HissenGneg/adaptive_light/Hardware/UserInterface/UserInterface.kicad_pcb

## KiCad design Hardware/UserInterface/UserInterface.kicad_pcb (2024-05-02)

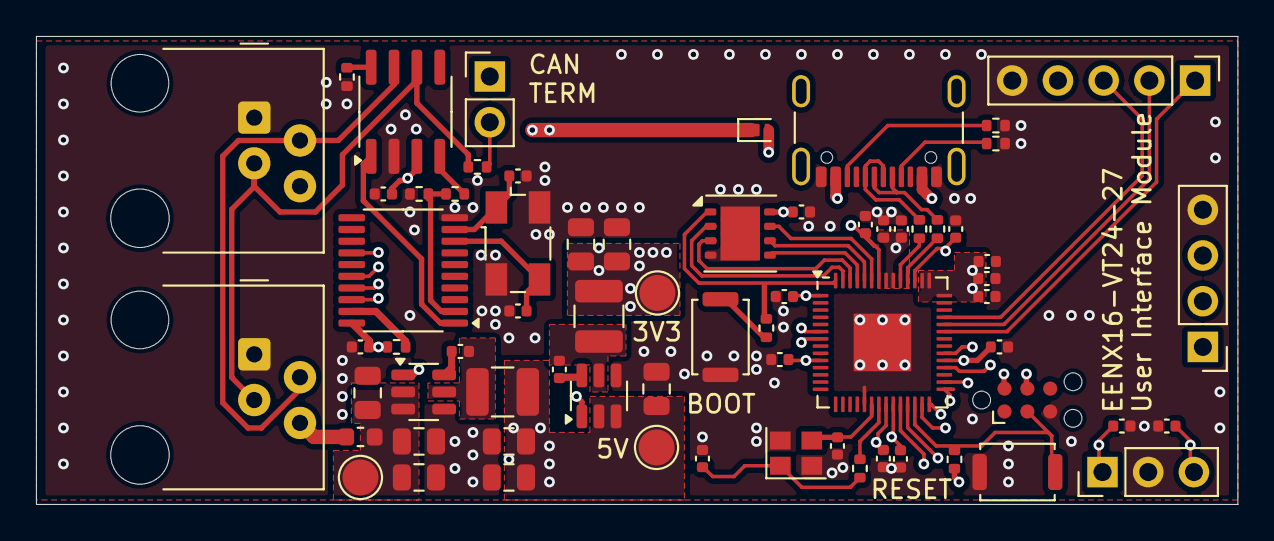
[picture p4: board UserInterface.kicad_pcb from above]

Board: 4 copper layers, 66.8 x 26.0 mm, 68 parts (0 on the bottom side), 51 nets.

Parts:
C101, C102, C201, C202, C203, C204, C205, C206, C207, C208, C209, C211, C212, C213, C303, C304, C307, C311: 100n; C_0402_1005Metric
C210: 1u; C_0402_1005Metric
C214, C215, C305, C306: 10p; C_0402_1005Metric
C301, C302, C308, C312: 10u; C_0805_2012Metric
C309, C310, C313, C314: 22u; C_0805_2012Metric
D201: D_Schottky; Nexperia_DSN1608-2_1.6x0.8mm
F301: 4A; Fuse_0603_1608Metric
J101: conn_turnSignal; PinHeader_1x03_P2.54mm_Vertical
J102: conn_OLED; PinHeader_1x04_P2.54mm_Vertical
J103: conn_joystick; PinHeader_1x05_P2.54mm_Vertical
J201: TagConnect_SWD; Tag-Connect_TC2030-IDC-NL_2x03_P1.27mm_Vertical
J202: USB_C_Receptacle_USB2.0_16P; USB_C_Receptacle_GCT_USB4105-xx-A_16P_TopMnt_Horizontal
J301, J302: RJ9; RJ9_Evercom_5301-440xxx_Horizontal
JP301: Jumper_termination; PinHeader_1x02_P2.54mm_Vertical
L301, L302: 4u7; L_1210_3225Metric
R201, R202, R302: 5k1; R_0402_1005Metric
R203, R303, R304, R305: 10k; R_0402_1005Metric
R204, R207: 1k; R_0402_1005Metric
R205, R206: 27; R_0402_1005Metric
R301: 120; R_0402_1005Metric
SW201, SW202: SW_Push; SW_Push_SPST_NO_Alps_SKRK
TP301: TPVin; TestPoint_Pad_D2.0mm
TP302: TP3V3; TestPoint_Pad_D2.0mm
TP303: TP5V; TestPoint_Pad_D2.0mm
U201: W25Q64JVXGIQ; WSON-8-1EP_4x4mm_P0.8mm_EP2.2x3mm
U202: RP2040; QFN-56-1EP_7x7mm_P0.4mm_EP3.2x3.2mm
U301: MCP2551-I-SN; SOIC-8_3.9x4.9mm_P1.27mm
U302: MCP2515-xST; TSSOP-20_4.4x6.5mm_P0.65mm
U303: AP63203WU; TSOT-23-6
U304: AP63205WU; TSOT-23-6
Y201: 12M; Crystal_SMD_2520-4Pin_2.5x2.0mm
Y301: 8M; Crystal_SMD_Abracon_ABM3B-4Pin_5.0x3.2mm

Connections:
+1V1: C210.1, C211.1, C212.1, U202.23 (DVDD), U202.45 (VREG_VOUT), U202.50 (DVDD)
+3V3: C201.1, C202.1, C203.1, C204.1, C205.1, C206.1, C207.1, C208.1, C209.1, C213.1, C303.1, C309.1, C310.1, J102.3, J103.4, L301.2, R203.1, R305.1, TP302.1, U201.8 (VCC), U202.1 (IOVDD), U202.10 (IOVDD), U202.22 (IOVDD), U202.33 (IOVDD), U202.42 (IOVDD), U202.43 (ADC_AVDD), U202.44 (VREG_IN), U202.48 (USB_VDD), U202.49 (IOVDD), U302.20 (VDD), U303.1 (FB)
+5V: C304.1, C308.1, C313.1, C314.1, D201.1 (K), L302.2, TP303.1, U301.3 (VDD), U303.2 (EN), U303.3 (IN), U304.1 (FB)
+SYSTEM: C301.1, C302.1, C312.1, F301.2, TP301.1, U304.2 (EN), U304.3 (IN)
/BTN: J103.1, U202.37 (GPIO25)
/BTN_LEFT: C102.2, J101.3, U202.34 (GPIO22)
/BTN_RIGHT: C101.1, J101.1, U202.32 (GPIO21)
/CAN_Bus+power/CANH: J301.2, J302.2, JP301.1 (A), U301.7 (CANH)
/CAN_Bus+power/CANL: J301.3, J302.3, R301.2, U301.6 (CANL)
/MISO: U202.27 (GPIO16), U302.17 (SO)
/MOSI: U202.30 (GPIO19), U302.16 (SI)
/Microcontroller/FLASH_CLK: U201.6 (CLK), U202.52 (QSPI_SCLK)
/Microcontroller/FLASH_IO0: U201.5 (DI(IO0)), U202.53 (QSPI_SD0)
/Microcontroller/FLASH_IO1: U201.2 (DO(IO1)), U202.55 (QSPI_SD1)
/Microcontroller/FLASH_IO2: U201.3 (IO2), U202.54 (QSPI_SD2)
/Microcontroller/FLASH_IO3: U201.7 (IO3), U202.51 (QSPI_SD3)
/Microcontroller/FLASH_~CS: R204.2, U201.1 (~CS), U202.56 (QSPI_SS)
/Microcontroller/RP2040_D+: R205.2, U202.47 (USB_DP)
/Microcontroller/RP2040_D-: R206.2, U202.46 (USB_DM)
/Microcontroller/SWCLK: J201.4 (SWCLK), U202.24 (SWCLK)
/Microcontroller/SWD: J201.2 (SWDIO), U202.25 (SWD)
/Microcontroller/USB_D+: J202.A6 (D+), J202.B6 (D+), R205.1
/Microcontroller/USB_D-: J202.A7 (D-), J202.B7 (D-), R206.1
/Microcontroller/XIN: C214.2, U202.20 (XIN), Y201.3
/Microcontroller/XOUT: R207.2, U202.21 (XOUT)
/Microcontroller/XOUT_R: C215.2, R207.1, Y201.1
/Microcontroller/~RESET: J201.3 (~RESET), R203.2, SW201.1, U202.26 (RUN)
/SCK: U202.29 (GPIO18), U302.14 (SCK)
/SCL: J102.2, U202.7 (GPIO5)
/SDA: J102.1, U202.6 (GPIO4)
/VR_x: J103.3, U202.39 (GPIO27_ADC1)
/VR_y: J103.2, U202.38 (GPIO26_ADC0)
/~CS: U202.28 (GPIO17), U302.18 (~CS)
GND: C101.2, C102.1, C201.2, C202.2, C203.2, C204.2, C205.2, C206.2, C207.2, C208.2, C209.2, C210.2, C211.2, C212.2, C213.2, C214.1, C215.1, C301.2, C302.2, C303.2, C304.2, C305.1, C306.1, C308.2, C309.2, C310.2, C312.2, C313.2, C314.2, J101.2, J102.4, J103.5, J201.5 (GND), J202.A1 (GND), J202.A12 (GND), J202.B1 (GND), J202.B12 (GND), J301.1, J302.1, R201.2, R202.2, R303.2, R304.2, SW201.2, SW202.1, U201.4 (GND), U201.9 (EP), U202.19 (TESTEN), U202.57 (GND), U301.2 (VSS), U302.10 (VSS), U303.4 (GND), U304.4 (GND), Y201.2, Y201.4, Y301.2, Y301.4
unnamed: D201.2 (A), J202.A4 (VBUS), J202.A9 (VBUS), J202.B4 (VBUS), J202.B9 (VBUS)
unnamed: F301.1, J301.4, J302.4
unnamed: J202.A5 (CC1), R202.1
unnamed: J202.B5 (CC2), R201.1
unnamed: JP301.2 (B), R301.1
unnamed: R204.1, SW202.2
unnamed: R302.1, U301.4 (RXD)
unnamed: R304.1, U301.8 (Rs)
unnamed: U301.1 (TXD), U302.1 (TXCAN)
unnamed: C306.2, U302.9 (OSC1), Y301.1
unnamed: C305.2, U302.8 (OSC2), Y301.3
unnamed: R302.2, R303.1, U302.2 (RXCAN)
unnamed: R305.2, U302.19 (~RESET)
unnamed: C307.2, U303.6 (BST)
unnamed: C307.1, L301.1, U303.5 (SW)
unnamed: C311.2, U304.6 (BST)
unnamed: C311.1, L302.1, U304.5 (SW)
