HissenGneg/adaptive_light/Hardware/Controller/Controller.kicad_pcb

## KiCad design Hardware/Controller/Controller.kicad_pcb (2024-05-02)

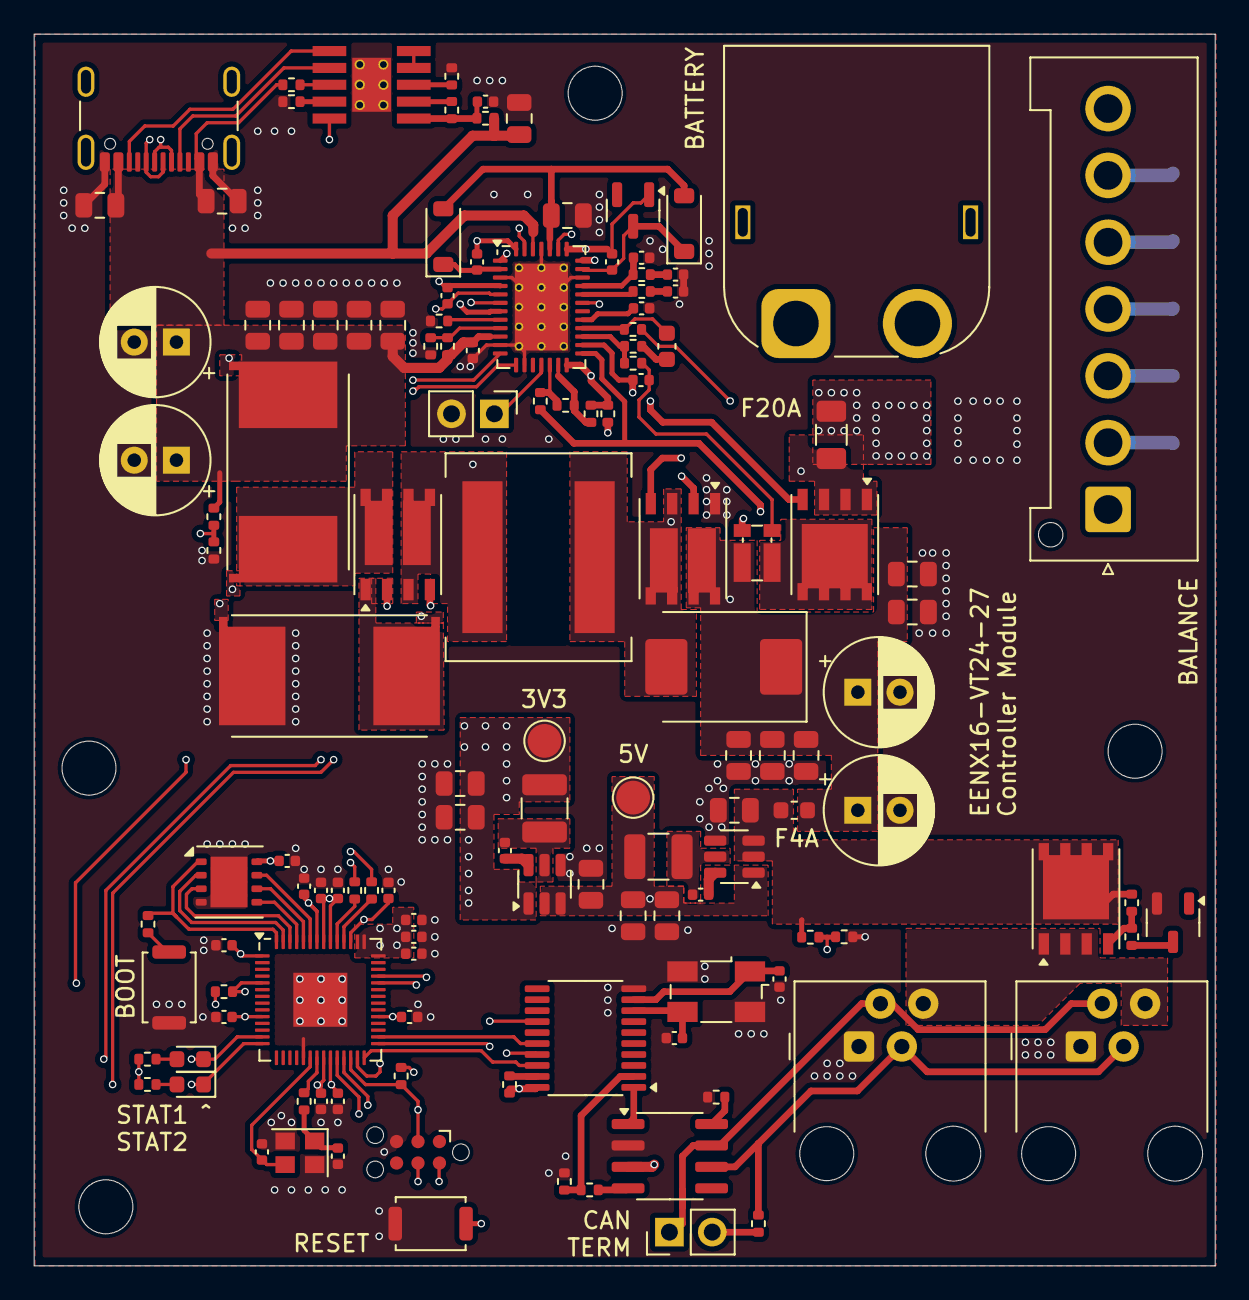
[picture p5: board Controller.kicad_pcb from above]

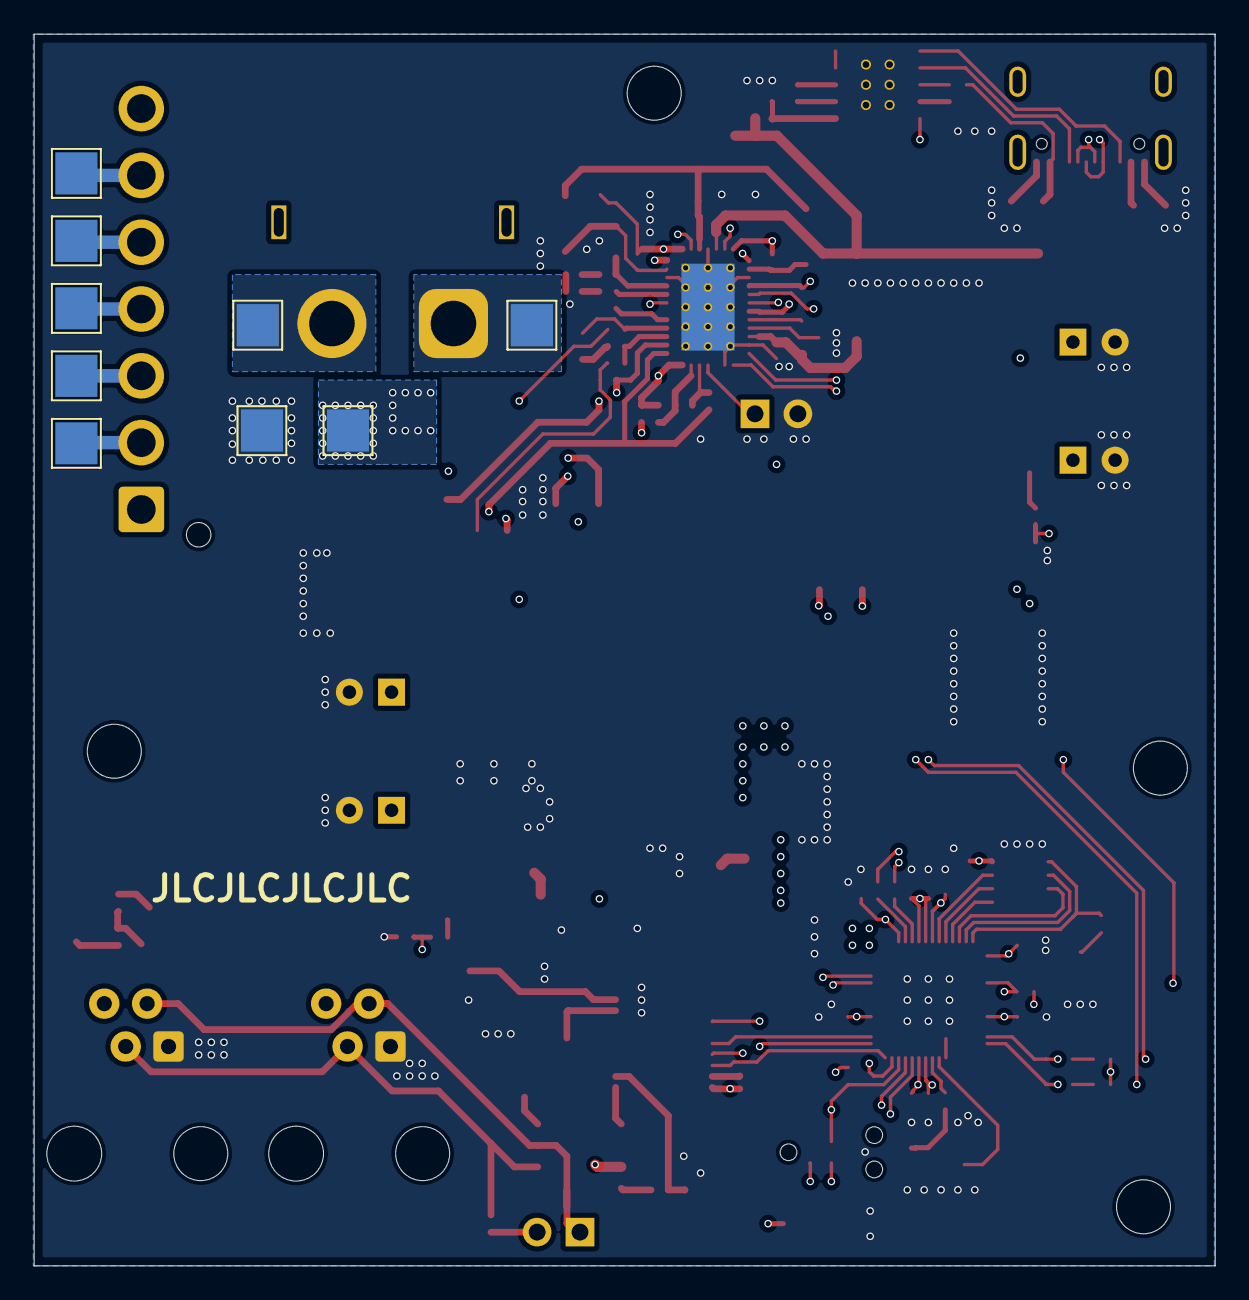
[picture p6: board Controller.kicad_pcb from below]

Board: 4 copper layers, 70.0 x 73.0 mm, 144 parts (9 on the bottom side), 102 nets.

Parts:
C201, C202, C203, C204, C205, C206, C207, C208, C209, C211, C212, C213, C401, C419, C432: 100n; C_0402_1005Metric
C210, C304, C423, C424: 1u; C_0402_1005Metric
C214, C215, C501, C502: 10p; C_0402_1005Metric
C301, C302, C303, C404, C405, C406, C407, C408, C409, C410, C411, C412, C413, C416, C420, C427: 10u; C_0805_2012Metric
C402, C403, C414, C415: 56u; CP_Radial_D6.3mm_P2.50mm
C417, C418, C421, C422: 22u; C_0805_2012Metric
C425: 2u2; C_0603_1608Metric
C426: 1n; C_0402_1005Metric
C428: 10n; C_0402_1005Metric
C429: 680p; C_0402_1005Metric
C430: 68p; C_0402_1005Metric
C431: 100p; C_0402_1005Metric
C433: 33n; C_0402_1005Metric
D401: MBRS360; D_SMC
D402: BZX84C6V2L; SOT-23
D403, D404: SBR0560S1; D_SOD-123
D405, D406: LED-GREEN; LED_0603_1608Metric
F401: 5A; Fuse_0603_1608Metric
F402: 20A; Fuse_1206_3216Metric
H101, H102, H103, H104: MountingHole; MountingHole_3.2mm_M3
J201: TagConnect_SWD; Tag-Connect_TC2030-IDC-NL_2x03_P1.27mm_Vertical
J301: USB_C_Receptacle_USB2.0_16P; USB_C_Receptacle_GCT_USB4105-xx-A_16P_TopMnt_Horizontal
J401: XT60; AMASS_XT60PW-M_1x02_P7.20mm_Horizontal
J402: Conn_balance; JST_VH_B7P-VH-FB-B_1x07_P3.96mm_Vertical
J403: Conn_NTC; PinHeader_1x02_P2.54mm_Vertical
J501, J502: RJ9; RJ9_Evercom_5301-440xxx_Horizontal
JP501: Jumper_termination; PinHeader_1x02_P2.54mm_Vertical
L401, L403: 4u7; L_1210_3225Metric
L402: XAL1010-153MED; L_Coilcraft_XAL1010-XXX
Q401, Q402: Si7252DP; PowerPAK_SO-8_Dual
Q403, Q501: Si7461DP; PowerPAK_SO-8_Single
Q502: Q_NMOS_GSD; SOT-23-3
R201, R302, R303, R304, R305, R306, R410, R420, R421, R501, R505, R506, R507: 10k; R_0402_1005Metric
R202, R205, R301, R416, R417, R418, R419: 1k; R_0402_1005Metric
R203, R204: 27; R_0402_1005Metric
R401, R402: 8m; R_Shunt_Vishay_WSR2_WSR3_KelvinConnection_4pins
R403, R408: 100; R_0402_1005Metric
R404: 105k; R_0402_1005Metric
R405, R406: 215k; R_0402_1005Metric
R407: 2m; R_Shunt_Vishay_WSKW0612
R409: 4R7; R_0402_1005Metric
R411, R412: 24k9; R_0402_1005Metric
R413: 100k; R_0402_1005Metric
R414: 56k; R_0402_1005Metric
R415: 47k; R_0402_1005Metric
R502, R504: 5k1; R_0402_1005Metric
R503: 120; R_0402_1005Metric
SW201, SW202: SW_Push; SW_Push_SPST_NO_Alps_SKRK
TP401: TP3V3; TestPoint_Pad_D2.0mm
TP402: TP5V; TestPoint_Pad_D2.0mm
TP403: BAT_S5; TestPoint_Pad_2.5x2.5mm
TP404: BAT_PROT+; TestPoint_Pad_2.5x2.5mm
TP405: BAT_UNPROT+; TestPoint_Pad_2.5x2.5mm
TP406: BAT_S4; TestPoint_Pad_2.5x2.5mm
TP407: BAT_PROT-; TestPoint_Pad_2.5x2.5mm
TP408: BAT_UNPROT-; TestPoint_Pad_2.5x2.5mm
TP409: BAT_S3; TestPoint_Pad_2.5x2.5mm
TP410: BAT_S2; TestPoint_Pad_2.5x2.5mm
TP411: BAT_S1; TestPoint_Pad_2.5x2.5mm
U201: W25Q64JVXGIQ; WSON-8-1EP_4x4mm_P0.8mm_EP2.2x3mm
U202: RP2040; QFN-56-1EP_7x7mm_P0.4mm_EP3.2x3.2mm
U301: CH224K; ESSOP10
U401: AP63203WU; TSOT-23-6
U402: AP63205WU; TSOT-23-6
U403: LTC4020; QFN-38-1EP_5x7mm_P0.5mm_EP3.15x5.15mm_ThermalVias
U501: MCP2551-I-SN; SOIC-8_3.9x4.9mm_P1.27mm
U502: MCP2515-xST; TSSOP-20_4.4x6.5mm_P0.65mm
Y201: 12M; Crystal_SMD_2520-4Pin_2.5x2.0mm
Y501: 8M; Crystal_SMD_Abracon_ABM3B-4Pin_5.0x3.2mm

Connections:
+1V1: C210.1, C211.1, C212.1, U202.23 (DVDD), U202.45 (VREG_VOUT), U202.50 (DVDD)
+3V3: C201.1, C202.1, C203.1, C204.1, C205.1, C206.1, C207.1, C208.1, C209.1, C213.1, C417.1, C418.1, L401.2, R201.1, R303.1, R416.1, R417.1, R507.1, TP401.1, U201.8 (VCC), U202.1 (IOVDD), U202.10 (IOVDD), U202.22 (IOVDD), U202.33 (IOVDD), U202.42 (IOVDD), U202.43 (ADC_AVDD), U202.44 (VREG_IN), U202.48 (USB_VDD), U202.49 (IOVDD), U401.1 (FB), U502.20 (VDD)
+5V: C416.1, C421.1, C422.1, L403.2, TP402.1, U401.2 (EN), U401.3 (IN), U402.1 (FB), U501.3 (VDD)
+SYSTEM: C420.1, F401.2, Q501.5 (D), R420.1, R501.1, U402.2 (EN), U402.3 (IN)
/BATTERY_MONITOR: R419.2, R420.2, U202.39 (GPIO27_ADC1)
/Battery/BAT: F402.1, Q403.1 (S), Q403.2 (S), Q403.3 (S), R406.1, U403.20 (BAT)
/Battery/BATT_RAW: C409.1, C410.1, C411.1, C412.1, C413.1, C414.1, C415.1, D401.1 (K), F401.1, Q402.5 (D), R405.1, R407.1
/Battery/BG1: Q401.2 (G), U403.37 (BG1)
/Battery/BG2: Q402.2 (G), U403.33 (BG2)
/Battery/BGATE: C426.2, Q403.4 (G), U403.21 (BGATE)
/Battery/BST1: C423.2, D403.1 (K), U403.2 (BST1)
/Battery/BST2: C424.1, D402.3 (K), D404.1 (K), U403.30 (BST2)
/Battery/CSN: R408.1, R409.2, U403.22 (CSN)
/Battery/CSOUT: C431.1, U403.24 (CSOUT)
/Battery/CSP: C425.1, R403.1, U403.23 (CSP)
/Battery/FBG: R411.2, R412.2, U403.18 (FBG)
/Battery/INTVcc: C427.1, D403.2 (A), D404.2 (A), U403.34 (INTVcc)
/Battery/ITH: R414.1, U403.27 (ITH)
/Battery/NTC: J403.1, U403.16 (NTC)
/Battery/RT: R413.1, U403.8 (RT)
/Battery/SENSBOT: C433.1, R402.2, U403.5 (SENSBOT)
/Battery/SENSGND: C433.2, R402.3, U403.4 (SENSGND)
/Battery/SENSTOP: R401.3, U403.6 (SENSTOP)
/Battery/SENSVin: R401.2, U403.7 (SENSVin)
/Battery/SHDN: R404.2, R410.1, U403.9 (SHDN)
/Battery/SW1: C423.1, L402.1, Q401.3 (S), Q401.6 (D), U403.38 (SW1)
/Battery/SW2: C424.2, D401.2 (A), D402.1 (A), L402.2, Q402.3 (S), Q402.6 (D), U403.32 (SW2)
/Battery/TG1: Q401.4 (G), U403.1 (TG1)
/Battery/TG2: Q402.4 (G), U403.31 (TG2)
/Battery/VC: C430.1, R415.1, U403.28 (VC)
/Battery/Vfb: R406.2, R412.1, U403.17 (Vfb)
/Battery/Vfb_minmax: R405.2, R411.1, U403.19 (Vfbmin), U403.26 (Vfbmax)
/CAN_bus/CANH: J501.2, J502.2, JP501.1 (A), U501.7 (CANH)
/CAN_bus/CANL: J501.3, J502.3, R503.2, U501.6 (CANL)
/MISO: U202.27 (GPIO16), U502.17 (SO)
/MOSI: U202.30 (GPIO19), U502.16 (SI)
/Microcontroller/FLASH_CLK: U201.6 (CLK), U202.52 (QSPI_SCLK)
/Microcontroller/FLASH_IO0: U201.5 (DI(IO0)), U202.53 (QSPI_SD0)
/Microcontroller/FLASH_IO1: U201.2 (DO(IO1)), U202.55 (QSPI_SD1)
/Microcontroller/FLASH_IO2: U201.3 (IO2), U202.54 (QSPI_SD2)
/Microcontroller/FLASH_IO3: U201.7 (IO3), U202.51 (QSPI_SD3)
/Microcontroller/FLASH_~CS: R202.2, U201.1 (~CS), U202.56 (QSPI_SS)
/Microcontroller/RP2040_D+: R203.2, U202.47 (USB_DP)
/Microcontroller/RP2040_D-: R204.2, U202.46 (USB_DM)
/Microcontroller/SWCLK: J201.4 (SWCLK), U202.24 (SWCLK)
/Microcontroller/SWD: J201.2 (SWDIO), U202.25 (SWD)
/Microcontroller/XIN: C214.2, U202.20 (XIN), Y201.3
/Microcontroller/XOUT: R205.2, U202.21 (XOUT)
/Microcontroller/XOUT_R: C215.2, R205.1, Y201.1
/Microcontroller/~RESET: J201.3 (~RESET), R201.2, SW201.1, U202.26 (RUN)
/PG: R303.2, U202.5 (GPIO3), U301.10 (PG)
/SCK: U202.29 (GPIO18), U502.14 (SCK)
/STAT1_OUT: D405.1 (K), U202.13 (GPIO10), U403.12 (STAT1)
/STAT2_OUT: D406.1 (K), U202.14 (GPIO11), U403.13 (STAT2)
/USBC/CC1: J301.A5 (CC1), U301.7 (CC1)
/USBC/CC2: J301.B5 (CC2), U301.6 (CC2)
/USBC/VDDCH: C304.1, R301.2, R304.1, U301.1 (VDD)
/USB_D+: J301.A6 (D+), J301.B6 (D+), R203.1
/USB_D-: J301.A7 (D-), J301.B7 (D-), R204.1
/VBUS_MONITOR: R418.2, R421.2, U202.38 (GPIO26_ADC0)
/~CS: U202.28 (GPIO17), U502.18 (~CS)
GND: C201.2, C202.2, C203.2, C204.2, C205.2, C206.2, C207.2, C208.2, C209.2, C210.2, C211.2, C212.2, C213.2, C214.1, C215.1, C301.2, C302.2, C303.2, C304.2, C402.2, C403.2, C404.2, C405.2, C406.2, C407.2, C408.2, C409.2, C410.2, C411.2, C412.2, C413.2, C414.2, C415.2, C416.2, C417.2, C418.2, C420.2, C421.2, C422.2, C427.2, C428.2, C429.2, C430.2, C431.2, C432.2, C501.1, C502.1, J201.5 (GND), J301.A1 (GND), J301.A12 (GND), J301.B1 (GND), J301.B12 (GND), J403.2, J501.1, J502.1, Q402.1 (S), Q502.2 (S), R305.2, R306.2, R402.4, R410.2, R413.2, R418.1, R419.1, R505.2, R506.2, SW201.2, SW202.1, TP407.1, U201.4 (GND), U201.9 (EP), U202.19 (TESTEN), U202.57 (GND), U301.11 (GND), U401.4 (GND), U402.4 (GND), U403.3 (SGND), U403.11 (MODE), U403.14 (TIMER), U403.29 (SGND), U403.35 (PGND), U403.39 (GND), U501.2 (VSS), U502.10 (VSS), Y201.2, Y201.4, Y501.2, Y501.4
unnamed: C425.2, R409.1
unnamed: C426.1, R407.3, R408.2
unnamed: C428.1, R414.2
unnamed: C429.1, R415.2
unnamed: D405.2 (A), R416.2
unnamed: D406.2 (A), R417.2
unnamed: F402.2, TP404.1
unnamed: J401.1, TP408.1
unnamed: J401.2, TP405.1
unnamed: J402.2, TP411.1
unnamed: J402.3, TP410.1
unnamed: J402.4, TP409.1
unnamed: J402.5, TP406.1
unnamed: J402.6, TP403.1
unnamed: J501.4, J502.4, Q501.1 (S), Q501.2 (S), Q501.3 (S)
unnamed: JP501.2 (B), R503.1
unnamed: Q401.1 (S), R402.1
unnamed: Q401.5 (D), R401.4
unnamed: Q403.5 (D), R407.4
unnamed: Q501.4 (G), R501.2, R502.1
unnamed: Q502.3 (D), R502.2
unnamed: R202.1, SW202.2
unnamed: R403.2, R407.2
unnamed: R306.1, U301.9 (CFG1)
unnamed: R304.2, U301.2 (CFG2)
unnamed: R305.1, U301.3 (CFG3)
unnamed: U301.4 (DP), U301.5 (DM)
unnamed: R302.2, U301.8 (VBUS)
unnamed: C401.2, U401.6 (BST)
unnamed: C401.1, L401.1, U401.5 (SW)
unnamed: C419.2, U402.6 (BST)
unnamed: C419.1, L403.1, U402.5 (SW)
unnamed: R504.1, U501.4 (RXD)
unnamed: R506.1, U501.8 (Rs)
unnamed: U501.1 (TXD), U502.1 (TXCAN)
unnamed: C502.2, U502.9 (OSC1), Y501.1
unnamed: C501.2, U502.8 (OSC2), Y501.3
unnamed: R504.2, R505.1, U502.2 (RXCAN)
unnamed: R507.2, U502.19 (~RESET)
VBUS: C301.1, C302.1, C303.1, C402.1, C403.1, C404.1, C405.1, C406.1, C407.1, C408.1, C432.1, J301.A4 (VBUS), J301.A9 (VBUS), J301.B4 (VBUS), J301.B9 (VBUS), R301.1, R302.1, R401.1, R404.1, R421.1, U403.10 (Vin_reg), U403.36 (PVin)
