HissenGneg/adaptive_light/Hardware/Controller/DC-DC-bodge/DC-DC-bodge.kicad_pcb

## KiCad design Hardware/Controller/DC-DC-bodge/DC-DC-bodge.kicad_pcb (2024-05-02)

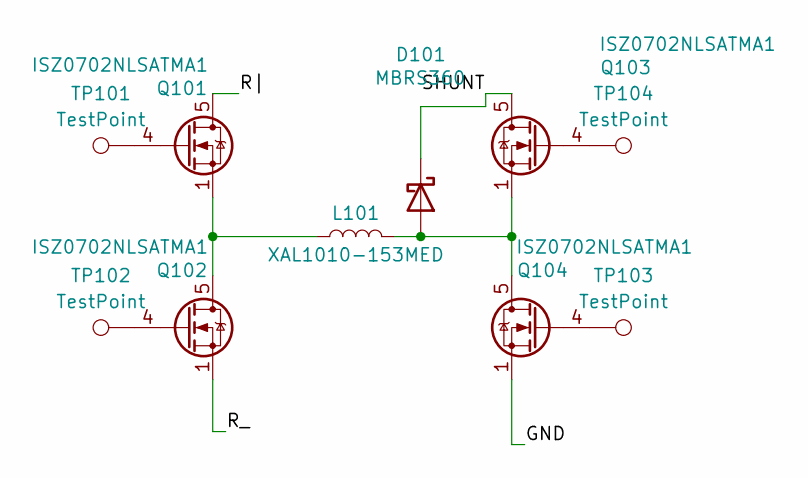
[picture p7: schematic DC-DC-bodge.kicad_sch]

Parts:
D101: MBRS360; D_SMC; mouser 78-VS-MBRS360-M39AT
L101: XAL1010-153MED; L_Coilcraft_XAL1010-XXX; mouser 994-XAL1010-153MED
Q101, Q102, Q103, Q104: ISZ0702NLSATMA1; VSON-8_3.3x3.3mm_P0.65mm_NexFET_not_very_fucking_stupid_as_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; mouser 726-ISZ0702NLSATMA1
TP101, TP102, TP103, TP104: TestPoint; TestPoint_Pad_2.0x2.0mm

Connections:
/GND: Q104.1 (S), Q104.2 (S), Q104.3 (S)
/R_: Q102.1 (S), Q102.2 (S), Q102.3 (S)
/R|: Q101.5 (D)
/SHUNT: D101.1 (K), Q103.5 (D)
unnamed: D101.2 (A), L101.2, Q103.1 (S), Q103.2 (S), Q103.3 (S), Q104.5 (D)
unnamed: Q101.4 (G), TP101.1
unnamed: L101.1, Q101.1 (S), Q101.2 (S), Q101.3 (S), Q102.5 (D)
unnamed: Q102.4 (G), TP102.1
unnamed: Q103.4 (G), TP104.1
unnamed: Q104.4 (G), TP103.1

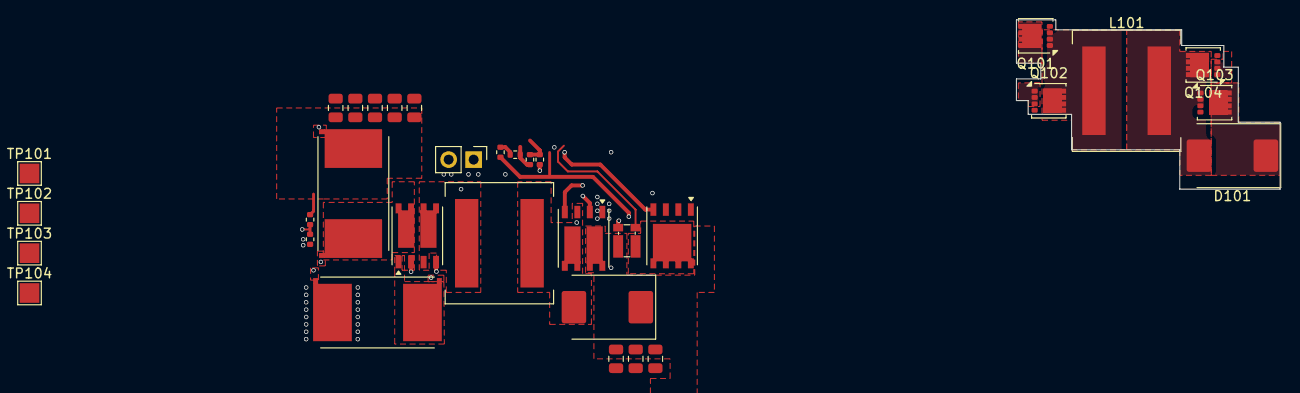
[picture p8: board DC-DC-bodge.kicad_pcb from above]

Board: 2 copper layers, 26.8 x 17.2 mm, 33 parts (0 on the bottom side), 9 nets.

Other parts of the board:
C404, C405, C406, C407, C408, C409, C410, C411: 10u; C_0805_2012Metric
D401: MBRS360; D_SMC
J403: Conn_NTC; PinHeader_1x02_P2.54mm_Vertical
L402: XAL1010-153MED; L_Coilcraft_XAL1010-XXX
Q401, Q402: Si7252DP; PowerPAK_SO-8_Dual
Q403: Si7461DP; PowerPAK_SO-8_Single
R401, R402: 8m; R_Shunt_Vishay_WSR2_WSR3_KelvinConnection_4pins
R405, R406: 215k; R_0402_1005Metric
R407: 2m; R_Shunt_Vishay_WSKW0612
R411, R412: 24k9; R_0402_1005Metric
R418: 1k; R_0402_1005Metric
R421: 10k; R_0402_1005Metric
