HissenGneg/adaptive_light/Hardware/LED_Module/LED_Module.kicad_pcb

## KiCad design Hardware/LED_Module/LED_Module.kicad_pcb (2024-03-26)

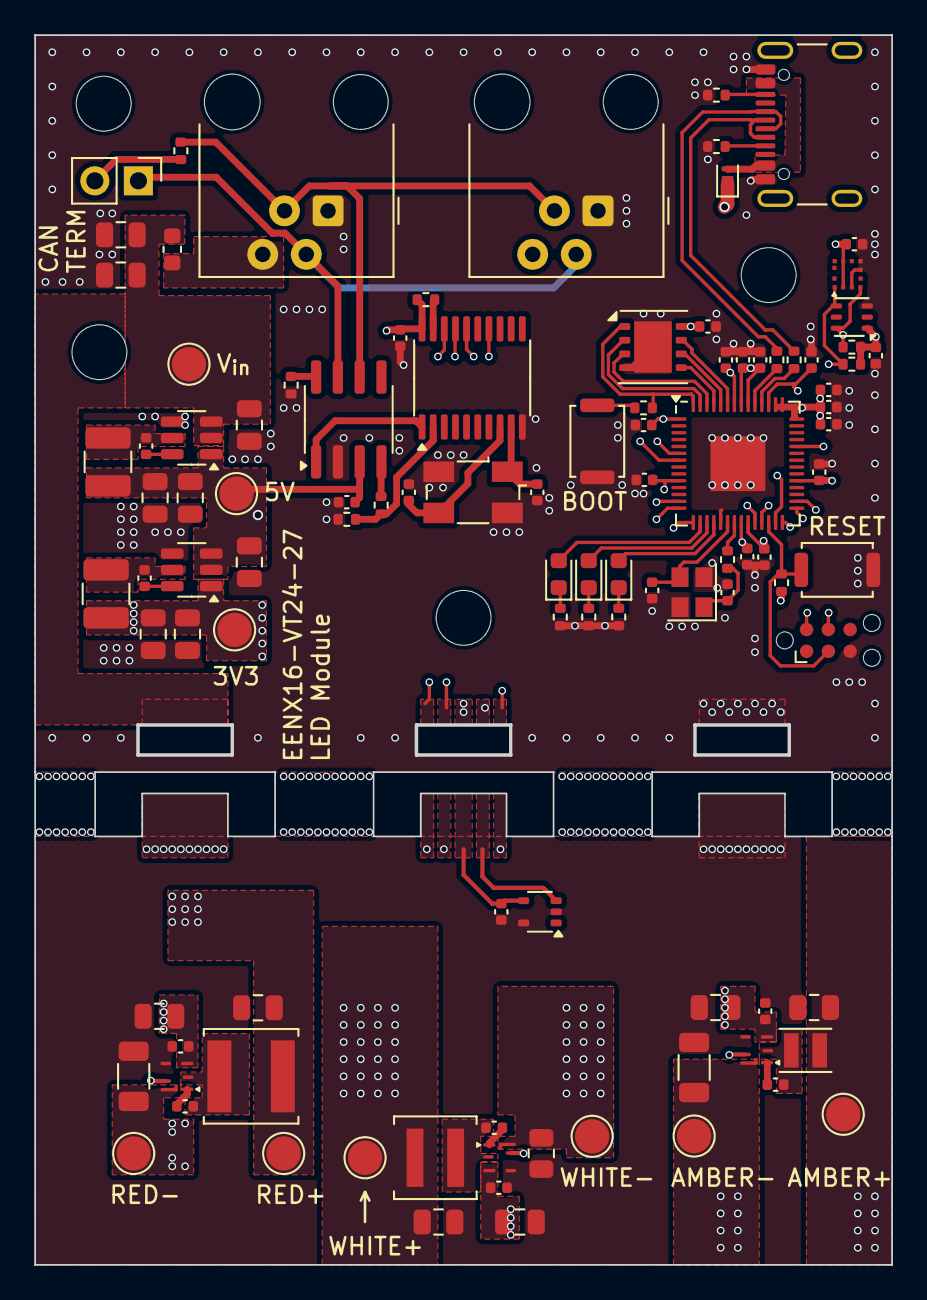
[picture p9: board LED_Module.kicad_pcb from above]

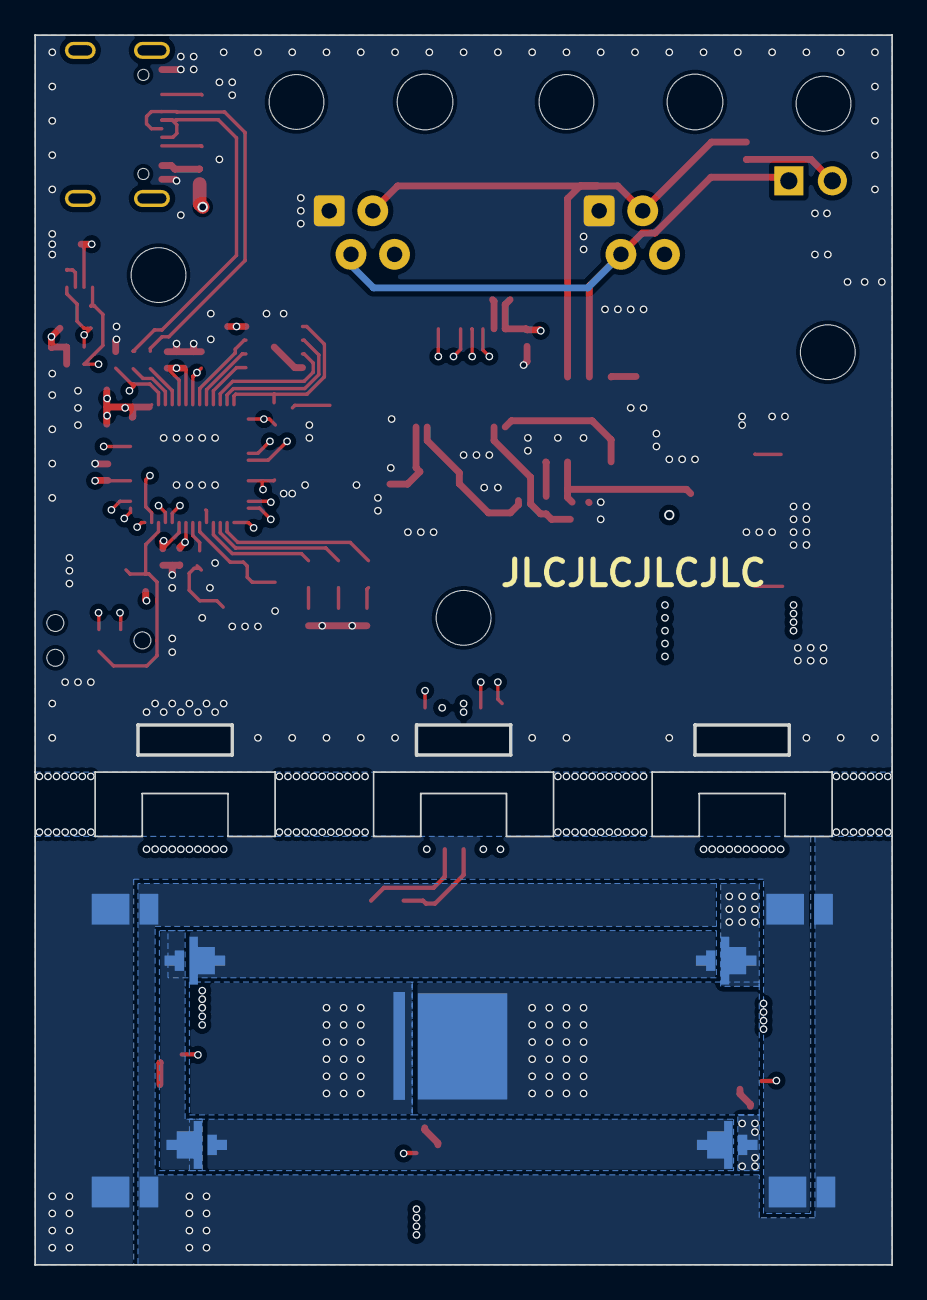
[picture p10: board LED_Module.kicad_pcb from below]

Board: 4 copper layers, 50.0 x 71.8 mm, 117 parts (9 on the bottom side), 71 nets.

Parts:
C201, C202, C302, C306, C501, C503, C507, C508, C509, C512: 10u; C_0805_2012Metric
C203, C204, C301, C305, C401, C402, C403, C404, C405, C406, C407, C408, C409, C411, C412, C413, C502, C504, C505, C506, C510, C511, C513, C601, C602: 100n; C_0402_1005Metric
C205, C206, C414, C415: 10p; C_0402_1005Metric
C303, C304, C307, C308: 22u; C_0805_2012Metric
C410: 1u; C_0402_1005Metric
D401: D_Schottky; Nexperia_DSN1608-2_1.6x0.8mm
D501, D503, D504, D505: LED-red; KR DMLQ32. 23
D502: LED-main; LUXEON 7070
D506, D507, D508, D509: LED-amber; JE2835_Amber
D601: R; LED_0603_1608Metric
D602: G; LED_0603_1608Metric
D603: B; LED_0603_1608Metric
F201: 4A; Fuse_0603_1608Metric
H101, H102, H103, H104: MountingHole; MountingHole_3.2mm_M3
J201, J202: RJ9; RJ9_Evercom_5301-440xxx_Horizontal
J401: USB_C_Receptacle_USB2.0_16P; USB_C_Receptacle_GCT_USB4105-xx-A_16P_TopMnt_Horizontal
J402: TagConnect_SWD; Tag-Connect_TC2030-IDC-NL_2x03_P1.27mm_Vertical
JP201: Jumper_termination; PinHeader_1x02_P2.54mm_Vertical
L301, L302: 4u7; L_1210_3225Metric
L501: 20u; L_Changjiang_FNR5045S
L502: 15u; L_Coilcraft_XAL4040-XXX
L503: 5.6u; L_Sunlord_SWPA252012S
R201, R603, R604, R605: 120; R_0402_1005Metric
R202, R401, R402, R601, R602: 5k1; R_0402_1005Metric
R203, R204, R205, R403: 10k; R_0402_1005Metric
R404, R407: 1k; R_0402_1005Metric
R405, R406: 27; R_0402_1005Metric
R501: 100m; R_0805_2012Metric
R502, R503: 200m; R_1206_3216Metric
SW401, SW402: SW_Push; SW_Push_SPST_NO_Alps_SKRK
TP201: TPVin; TestPoint_Pad_D2.0mm
TP301: TP3V3; TestPoint_Pad_D2.0mm
TP302: TP5V; TestPoint_Pad_D2.0mm
TP501: TPLED2+; TestPoint_Pad_D2.0mm
TP502: TPLED1+; TestPoint_Pad_D2.0mm
TP503: TPLED1-; TestPoint_Pad_D2.0mm
TP504: TPLED2-; TestPoint_Pad_D2.0mm
TP505: TPLED3+; TestPoint_Pad_D2.0mm
TP506: TPLED3-; TestPoint_Pad_D2.0mm
U201: MCP2551-I-SN; SOIC-8_3.9x4.9mm_P1.27mm
U202: MCP2515-xST; TSSOP-20_4.4x6.5mm_P0.65mm
U301: AP63203WU; TSOT-23-6
U302: AP63205WU; TSOT-23-6
U401: W25Q64JVXGIQ; WSON-8-1EP_4x4mm_P0.8mm_EP2.2x3mm
U402: RP2040; QFN-56-1EP_7x7mm_P0.4mm_EP3.2x3.2mm
U501, U502, U503: TPS92200; VQFN-HR-6pin-TexasInstruments
U504: TMP236; SOT-353_SC-70-5
U601: MC3479
U602: LTR-303ALS-01; Lite-On_LTR-303ALS-01
Y201: 8M; Crystal_SMD_Abracon_ABM3B-4Pin_5.0x3.2mm
Y401: 12M; Crystal_SMD_2520-4Pin_2.5x2.0mm

Connections:
+1V1: C410.1, C411.1, C412.1, U402.23 (DVDD), U402.45 (VREG_VOUT), U402.50 (DVDD)
+3V3: C203.1, C303.1, C304.1, C401.1, C402.1, C403.1, C404.1, C405.1, C406.1, C407.1, C408.1, C409.1, C413.1, C513.1, C601.1, C602.1, L301.2, R205.1, R403.1, R601.1, R602.1, TP301.1, U202.20 (VDD), U301.1 (FB), U401.8 (VCC), U402.1 (IOVDD), U402.10 (IOVDD), U402.22 (IOVDD), U402.33 (IOVDD), U402.42 (IOVDD), U402.43 (ADC_AVDD), U402.44 (VREG_IN), U402.48 (USB_VDD), U402.49 (IOVDD), U504.4 (V_{DD}), U601.2 (CSN), U601.9 (VDD), U602.1 (VDD)
+5V: C204.1, C302.1, C307.1, C308.1, D401.1 (K), L302.2, TP302.1, U201.3 (VDD), U301.2 (EN), U301.3 (IN), U302.1 (FB)
+SYSTEM: C201.1, C202.1, C306.1, C501.1, C502.1, C503.1, C504.1, C509.1, C510.1, F201.2, TP201.1, U302.2 (EN), U302.3 (IN), U501.3 (Vin), U502.3 (Vin), U503.3 (Vin)
/CAN_bus/CANH: J201.2, J202.2, JP201.1 (A), U201.7 (CANH)
/CAN_bus/CANL: J201.3, J202.3, R201.2, U201.6 (CANL)
/LED_TEMP: U402.38 (GPIO26_ADC0), U504.3 (V_{OUT})
/MISO: U202.17 (SO), U402.27 (GPIO16)
/MOSI: U202.16 (SI), U402.30 (GPIO19)
/Microcontroller/FLASH_CLK: U401.6 (CLK), U402.52 (QSPI_SCLK)
/Microcontroller/FLASH_IO0: U401.5 (DI(IO0)), U402.53 (QSPI_SD0)
/Microcontroller/FLASH_IO1: U401.2 (DO(IO1)), U402.55 (QSPI_SD1)
/Microcontroller/FLASH_IO2: U401.3 (IO2), U402.54 (QSPI_SD2)
/Microcontroller/FLASH_IO3: U401.7 (IO3), U402.51 (QSPI_SD3)
/Microcontroller/FLASH_~CS: R404.2, U401.1 (~CS), U402.56 (QSPI_SS)
/Microcontroller/RP2040_D+: R405.2, U402.47 (USB_DP)
/Microcontroller/RP2040_D-: R406.2, U402.46 (USB_DM)
/Microcontroller/SWCLK: J402.4 (SWCLK), U402.24 (SWCLK)
/Microcontroller/SWD: J402.2 (SWDIO), U402.25 (SWD)
/Microcontroller/USB_D+: J401.A6 (D+), J401.B6 (D+), R405.1
/Microcontroller/USB_D-: J401.A7 (D-), J401.B7 (D-), R406.1
/Microcontroller/XIN: C414.2, U402.20 (XIN), Y401.3
/Microcontroller/XOUT: R407.2, U402.21 (XOUT)
/Microcontroller/XOUT_R: C415.2, R407.1, Y401.1
/Microcontroller/~RESET: J402.3 (~RESET), R403.2, SW401.1, U402.26 (RUN)
/PWM_AMBER: U402.15 (GPIO12), U503.5 (DIM)
/PWM_RED: U402.14 (GPIO11), U501.5 (DIM)
/PWM_WHITE: U402.13 (GPIO10), U502.5 (DIM)
/SCK: U202.14 (SCK), U402.29 (GPIO18)
/SCL: R601.2, U402.7 (GPIO5), U601.1 (SCK_SCL), U602.4 (SCL)
/SDA: R602.2, U402.6 (GPIO4), U601.4 (DIN_SDA), U602.6 (SDA)
/STATUS1: D603.2 (A), U402.18 (GPIO15)
/STATUS2: D601.2 (A), U402.17 (GPIO14)
/STATUS3: D602.2 (A), U402.16 (GPIO13)
/~CS: U202.18 (~CS), U402.28 (GPIO17)
GND: C201.2, C202.2, C203.2, C204.2, C205.1, C206.1, C302.2, C303.2, C304.2, C306.2, C307.2, C308.2, C401.2, C402.2, C403.2, C404.2, C405.2, C406.2, C407.2, C408.2, C409.2, C410.2, C411.2, C412.2, C413.2, C414.1, C415.1, C501.2, C502.2, C503.2, C504.2, C507.2, C508.2, C509.2, C510.2, C512.2, C513.2, C601.2, C602.2, J201.1, J202.1, J401.A1 (GND), J401.A12 (GND), J401.B1 (GND), J401.B12 (GND), J402.5 (GND), R203.2, R204.2, R401.2, R402.2, R501.2, R502.2, R503.2, R603.2, R604.2, R605.2, SW401.2, SW402.1, U201.2 (VSS), U202.10 (VSS), U301.4 (GND), U302.4 (GND), U401.4 (GND), U401.9 (EP), U402.19 (TESTEN), U402.57 (GND), U501.4 (GND), U502.4 (GND), U503.4 (GND), U504.2 (GND), U504.5 (GND), U601.3 (DOUT_A6), U601.6 (GND), U601.7 (VPP), U602.3 (GND), Y201.2, Y201.4, Y401.2, Y401.4
unnamed: D401.2 (A), J401.A4 (VBUS), J401.A9 (VBUS), J401.B4 (VBUS), J401.B9 (VBUS)
unnamed: C507.1, D501.2 (A), L501.2, TP501.1
unnamed: D501.1 (K), D503.2 (A)
unnamed: C508.1, D502.2 (A), L502.2, TP502.1
unnamed: D502.1 (K), R501.1, TP503.1, U502.6 (FB)
unnamed: D503.1 (K), D504.2 (A)
unnamed: D504.1 (K), D505.2 (A)
unnamed: D505.1 (K), R502.1, TP504.1, U501.6 (FB)
unnamed: C512.1, D506.2 (A), D507.2 (A), D508.2 (A), D509.2 (A), L503.2, TP505.1
unnamed: D506.1 (K), D507.1 (K), D508.1 (K), D509.1 (K), R503.1, TP506.1, U503.6 (FB)
unnamed: D601.1 (K), R603.1
unnamed: D602.1 (K), R604.1
unnamed: D603.1 (K), R605.1
unnamed: F201.1, J201.4, J202.4
unnamed: J401.A5 (CC1), R402.1
unnamed: J401.B5 (CC2), R401.1
unnamed: JP201.2 (B), R201.1
unnamed: R404.1, SW402.2
unnamed: R202.1, U201.4 (RXD)
unnamed: R204.1, U201.8 (Rs)
unnamed: U201.1 (TXD), U202.1 (TXCAN)
unnamed: C206.2, U202.9 (OSC1), Y201.1
unnamed: C205.2, U202.8 (OSC2), Y201.3
unnamed: R202.2, R203.1, U202.2 (RXCAN)
unnamed: R205.2, U202.19 (~RESET)
unnamed: C301.2, U301.6 (BST)
unnamed: C301.1, L301.1, U301.5 (SW)
unnamed: C305.2, U302.6 (BST)
unnamed: C305.1, L302.1, U302.5 (SW)
unnamed: C505.1, U501.1 (BOOT)
unnamed: C505.2, L501.1, U501.2 (SW)
unnamed: C506.1, U502.1 (BOOT)
unnamed: C506.2, L502.1, U502.2 (SW)
unnamed: C511.1, U503.1 (BOOT)
unnamed: C511.2, L503.1, U503.2 (SW)
