HissenGneg/adaptive_light/(commit log)

2024-02-29 La till allt
    yes
    [Battery.kicad_sch, CAN_bus.kicad_sch, Controller.kicad_pcb, Controller.kicad_sch, LED_Module.kicad_pcb, LED_Module.kicad_sch, LED_driver.kicad_sch, Microcontroller.kicad_sch]
2024-03-01 Controller fixades
    [Battery.kicad_sch, CAN_bus.kicad_sch, Controller.kicad_sch, Microcontroller.kicad_sch, USBC.kicad_sch]
2024-03-19 La in allt
    Myyycket saker
    [Battery.kicad_sch, CAN_Bus+power.kicad_sch, CAN_bus.kicad_sch, LED_Module.kicad_pcb, LED_Module.kicad_sch, LED_driver.kicad_sch, LED_module_v1.csv, Microcontroller.kicad_sch]
2024-03-19 User interface fix
    [Battery.kicad_sch, CAN_Bus+power.kicad_sch, CAN_bus.kicad_sch, LED_Module.kicad_pcb, LED_driver.kicad_sch, Microcontroller.kicad_sch, Power.kicad_sch, Sensors.kicad_sch]
2024-03-20 LED module go brrrrrrrrrrrrrrrrrr
    [CAN_bus.kicad_sch, LED_Module.kicad_pcb, LED_Module.kicad_sch, LED_driver.kicad_sch]
2024-03-24 User interface and Controller done
    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
    [Battery.kicad_sch, CAN_Bus+power.kicad_sch, CAN_bus.kicad_sch, Controller.kicad_pcb, Controller.kicad_sch, LED_Module.kicad_pcb, LED_Module.kicad_sch, LED_driver.kicad_sch]
2024-03-26 Changes and fixes
    [CAN_bus.kicad_sch, Controller.kicad_pcb, LED_Module.kicad_pcb, Microcontroller.kicad_sch, UserInterface.kicad_pcb]
2024-03-26 final fixes (hopefully) (GONE WRONG?!) (real)
    [Battery.kicad_sch, CAN_Bus+power.kicad_sch, CAN_bus.kicad_sch, Controller.kicad_pcb, Controller.kicad_sch, LED_Module.kicad_pcb, LED_Module.kicad_sch, LED_driver.kicad_sch]
2024-05-02 Add software files
    [Battery.kicad_sch, Controller.kicad_pcb, Controller.kicad_sch, DC-DC-bodge.kicad_pcb, DC-DC-bodge.kicad_sch, USBC.kicad_sch, UserInterface.kicad_pcb, bom.csv]
